Danny-Fuego/MicromouseDB/hardware/pcb/Micromouse.kicad_pcb

## KiCad design hardware/pcb/Micromouse.kicad_pcb (2026-08-09)

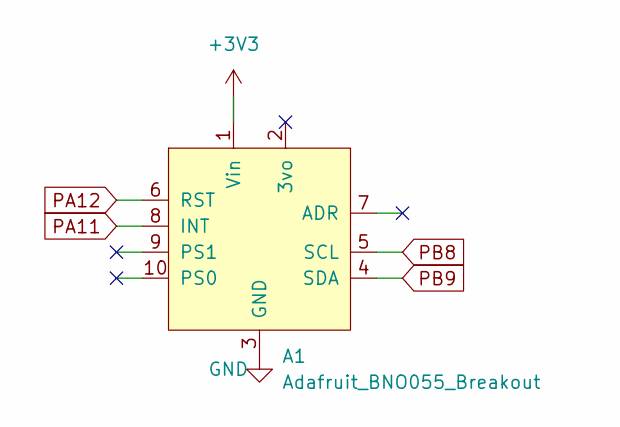
[picture p1: schematic Gyro.kicad_sch]

Parts:
A1: Adafruit_BNO055_Breakout; MODULE_2472

Connections:
+3V3: A1.1 (Vin); also elsewhere on the board
GND: A1.3 (GND); also elsewhere on the board
PA11: A1.8 (INT); also elsewhere on the board
PA12: A1.6 (RST); also elsewhere on the board
PB8: A1.5 (SCL); also elsewhere on the board
PB9: A1.4 (SDA); also elsewhere on the board

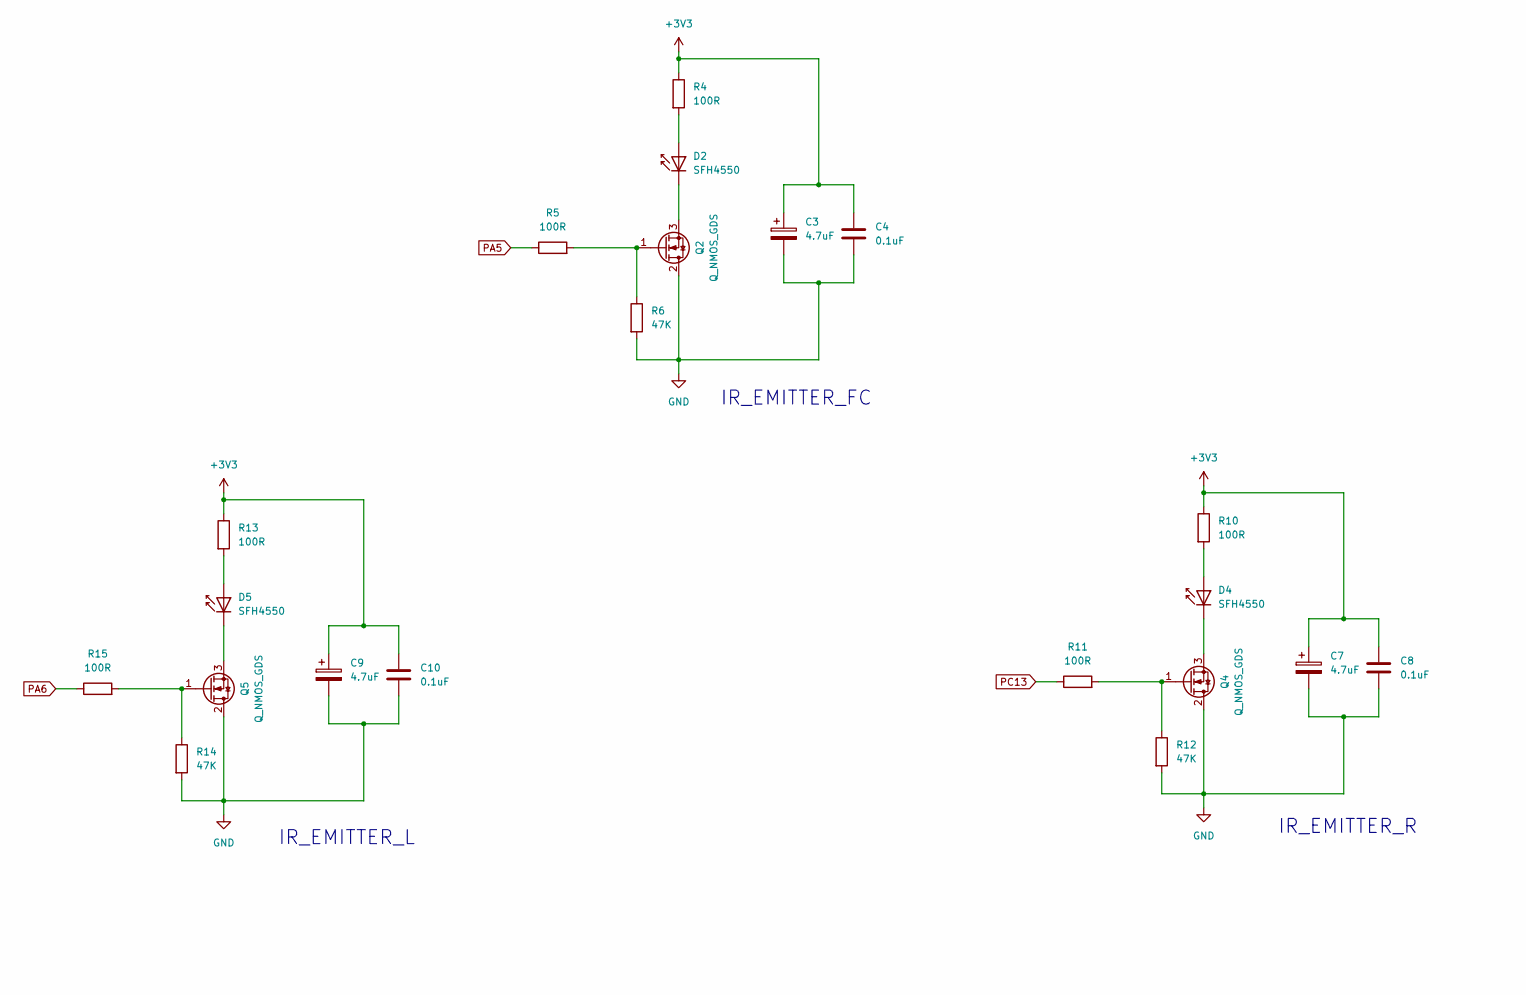
[picture p2: schematic IR_Sensors.kicad_sch, part in row 1, column 1]

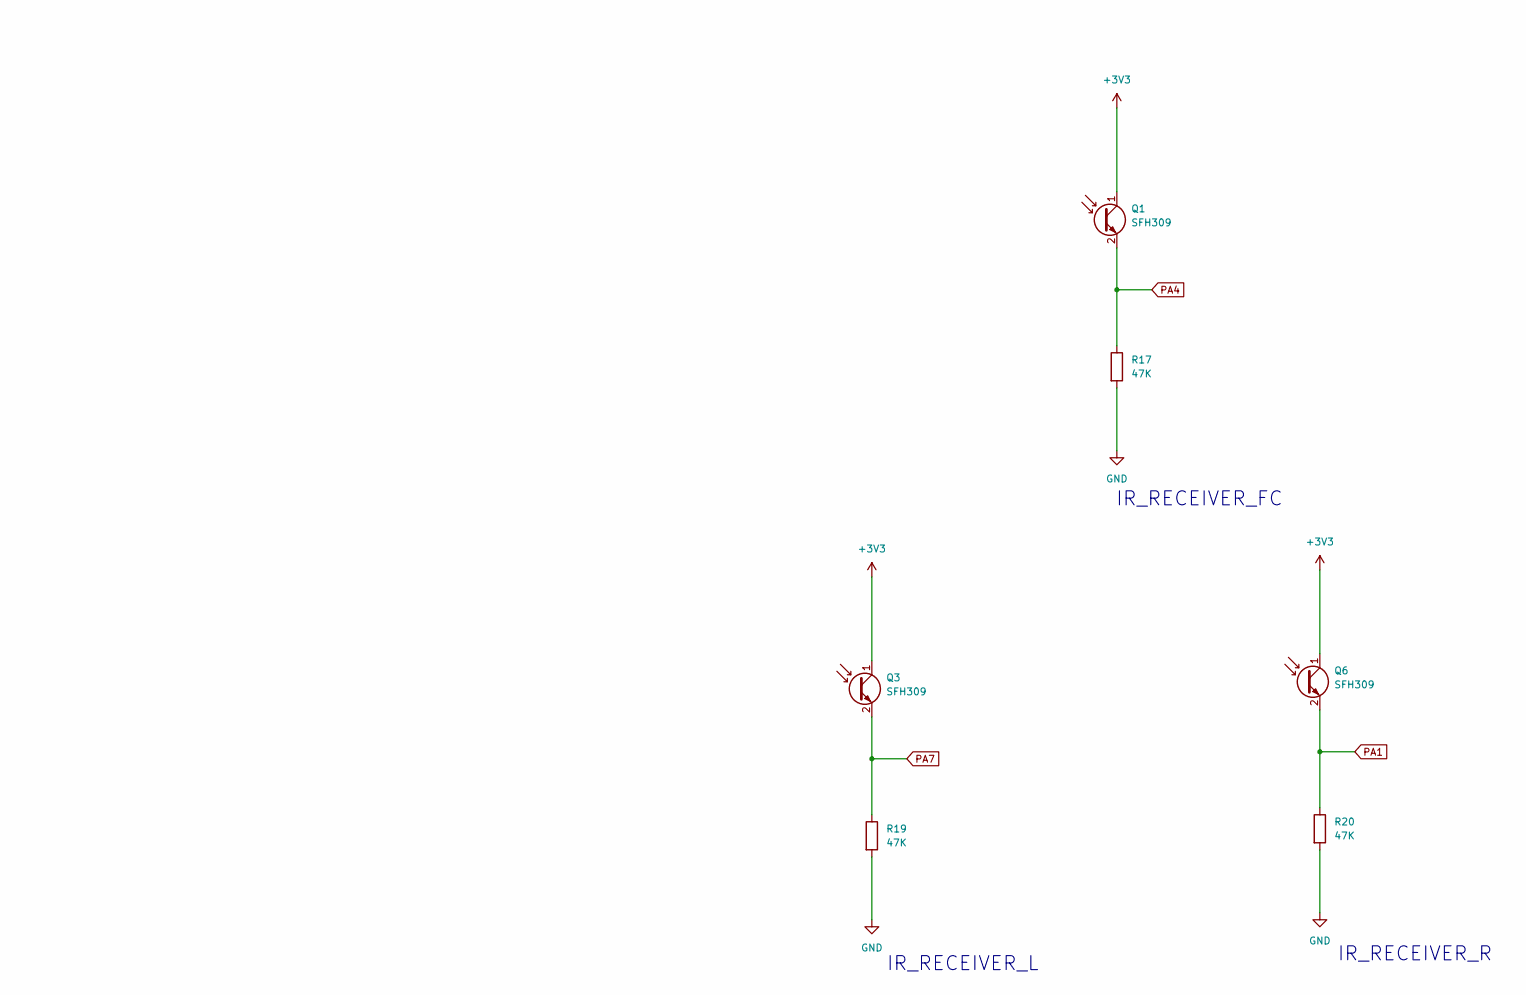
[picture p3: schematic IR_Sensors.kicad_sch, part in row 1, column 2]

Parts:
C3, C7, C9: 4.7uF; CP_Radial_D4.0mm_P1.50mm
C4, C8, C10: 0.1uF; C_0603_1608Metric
D2, D4, D5: SFH4550; LED_D3.0mm_IRGrey
Q1, Q3, Q6: SFH309; LED_D3.0mm_IRBlack
Q2, Q4, Q5: Q_NMOS_GDS; SOT-23
R4, R5, R10, R11, R13, R15: 100R; R_0603_1608Metric
R6, R12, R14, R17, R19, R20: 47K; R_0603_1608Metric

Connections:
+3V3: C3.1, C4.1, C7.1, C8.1, C9.1, C10.1, Q1.1 (C), Q3.1 (C), Q6.1 (C), R4.1, R10.1, R13.1; also elsewhere on the board
GND: C3.2, C4.2, C7.2, C8.2, C9.2, C10.2, Q2.2 (D), Q4.2 (D), Q5.2 (D), R6.2, R12.2, R14.2, R17.2, R19.2, R20.2; also elsewhere on the board
unnamed: D2.2 (A), R4.2
unnamed: D2.1 (K), Q2.3 (S)
unnamed: D4.2 (A), R10.2
unnamed: D4.1 (K), Q4.3 (S)
unnamed: D5.2 (A), R13.2
unnamed: D5.1 (K), Q5.3 (S)
unnamed: Q2.1 (G), R5.2, R6.1
unnamed: Q4.1 (G), R11.2, R12.1
unnamed: Q5.1 (G), R14.1, R15.2
PA1: Q6.2 (E), R20.1; also elsewhere on the board
PA4: Q1.2 (E), R17.1; also elsewhere on the board
PA5: R5.1; also elsewhere on the board
PA6: R15.1; also elsewhere on the board
PA7: Q3.2 (E), R19.1; also elsewhere on the board
PC13: R11.1; also elsewhere on the board

Notes on the sheet:
IR_RECEIVER_FC
IR_RECEIVER_L
IR_EMITTER_FC
IR_RECEIVER_R
IR_EMITTER_R
IR_EMITTER_L

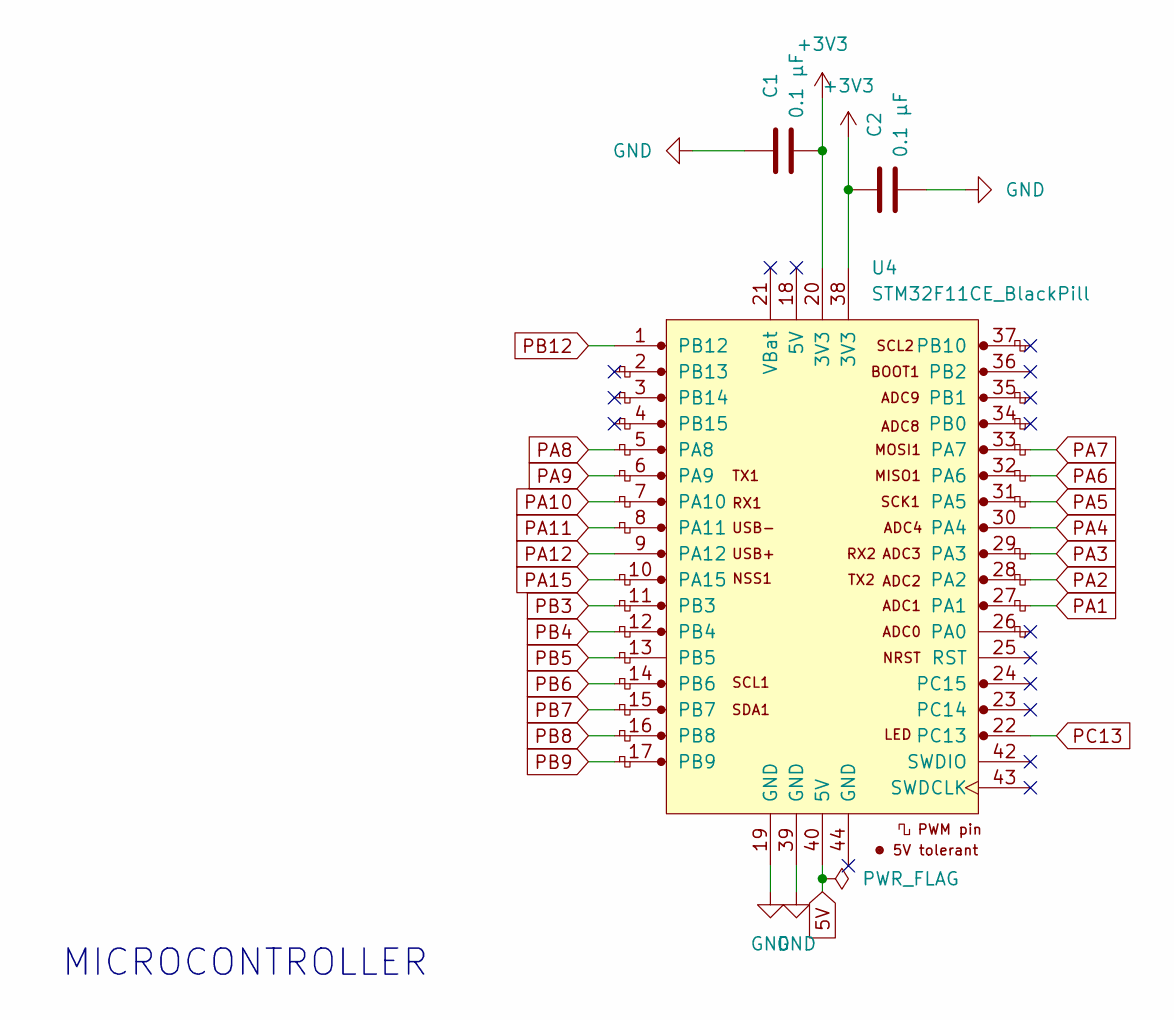
[picture p4: schematic Microcontroller.kicad_sch]

Parts:
C1, C2: 0.1 µF; C_0603_1608Metric
U4: STM32F11CE_BlackPill; YAAJ_BluePill_SWD_1

Connections:
5V: U4.40 (5V); also elsewhere on the board
+3V3: C1.2, C2.1, U4.20 (3V3), U4.38 (3V3); also elsewhere on the board
GND: C1.1, C2.2, U4.19 (GND), U4.39 (GND); also elsewhere on the board
PA1: U4.27 (PA1); also elsewhere on the board
PA2: U4.28 (PA2); also elsewhere on the board
PA3: U4.29 (PA3); also elsewhere on the board
PA4: U4.30 (PA4); also elsewhere on the board
PA5: U4.31 (PA5); also elsewhere on the board
PA6: U4.32 (PA6); also elsewhere on the board
PA7: U4.33 (PA7); also elsewhere on the board
PA8: U4.5 (PA8); also elsewhere on the board
PA9: U4.6 (PA9); also elsewhere on the board
PA10: U4.7 (PA10); also elsewhere on the board
PA11: U4.8 (PA11); also elsewhere on the board
PA12: U4.9 (PA12); also elsewhere on the board
PA15: U4.10 (PA15); also elsewhere on the board
PB3: U4.11 (PB3); also elsewhere on the board
PB4: U4.12 (PB4); also elsewhere on the board
PB5: U4.13 (PB5); also elsewhere on the board
PB6: U4.14 (PB6); also elsewhere on the board
PB7: U4.15 (PB7); also elsewhere on the board
PB8: U4.16 (PB8); also elsewhere on the board
PB9: U4.17 (PB9); also elsewhere on the board
PB12: U4.1 (PB12); also elsewhere on the board
PC13: U4.22 (PC13); also elsewhere on the board

Notes on the sheet:
MICROCONTROLLER

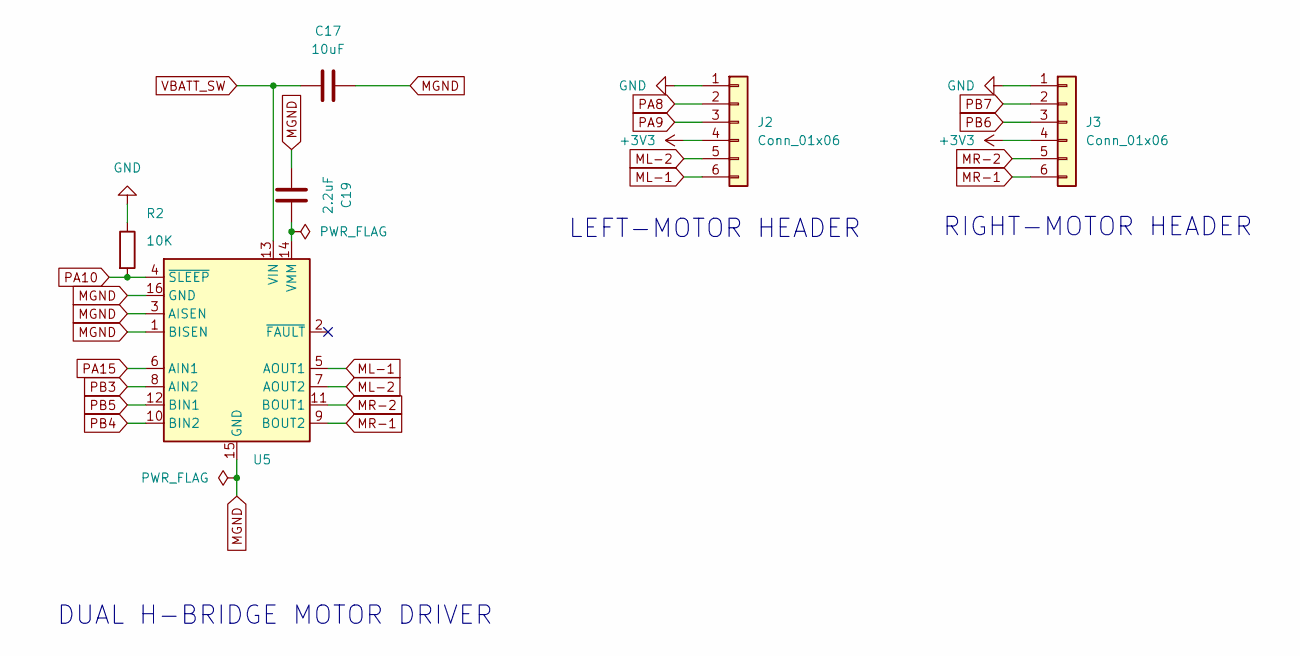
[picture p5: schematic Motor_Encoder.kicad_sch]

Parts:
C17: 10uF; C_0603_1608Metric
C19: 2.2uF; C_0603_1608Metric
J2, J3: Conn_01x06; PinHeader_1x06_P2.54mm_Vertical
R2: 10K; R_0603_1608Metric
U5: DRV8833_BreakoutBoard

Connections:
+3V3: J2.4, J3.4; also elsewhere on the board
GND: J2.1, J3.1, R2.1; also elsewhere on the board
MGND: C17.2, C19.1, U5.1 (BISEN), U5.3 (AISEN), U5.15 (GND), U5.16 (GND); also elsewhere on the board
ML-1: J2.6, U5.5 (AOUT1)
ML-2: J2.5, U5.7 (AOUT2)
MR-1: J3.6, U5.9 (BOUT2)
MR-2: J3.5, U5.11 (BOUT1)
unnamed: C19.2, U5.14 (VMM)
PA8: J2.2; also elsewhere on the board
PA9: J2.3; also elsewhere on the board
PA10: R2.2, U5.4 (~SLEEP); also elsewhere on the board
PA15: U5.6 (AIN1); also elsewhere on the board
PB3: U5.8 (AIN2); also elsewhere on the board
PB4: U5.10 (BIN2); also elsewhere on the board
PB5: U5.12 (BIN1); also elsewhere on the board
PB6: J3.3; also elsewhere on the board
PB7: J3.2; also elsewhere on the board
VBATT_SW: C17.1, U5.13 (VIN); also elsewhere on the board

Notes on the sheet:
DUAL H-BRIDGE MOTOR DRIVER
LEFT-MOTOR HEADER
RIGHT-MOTOR HEADER

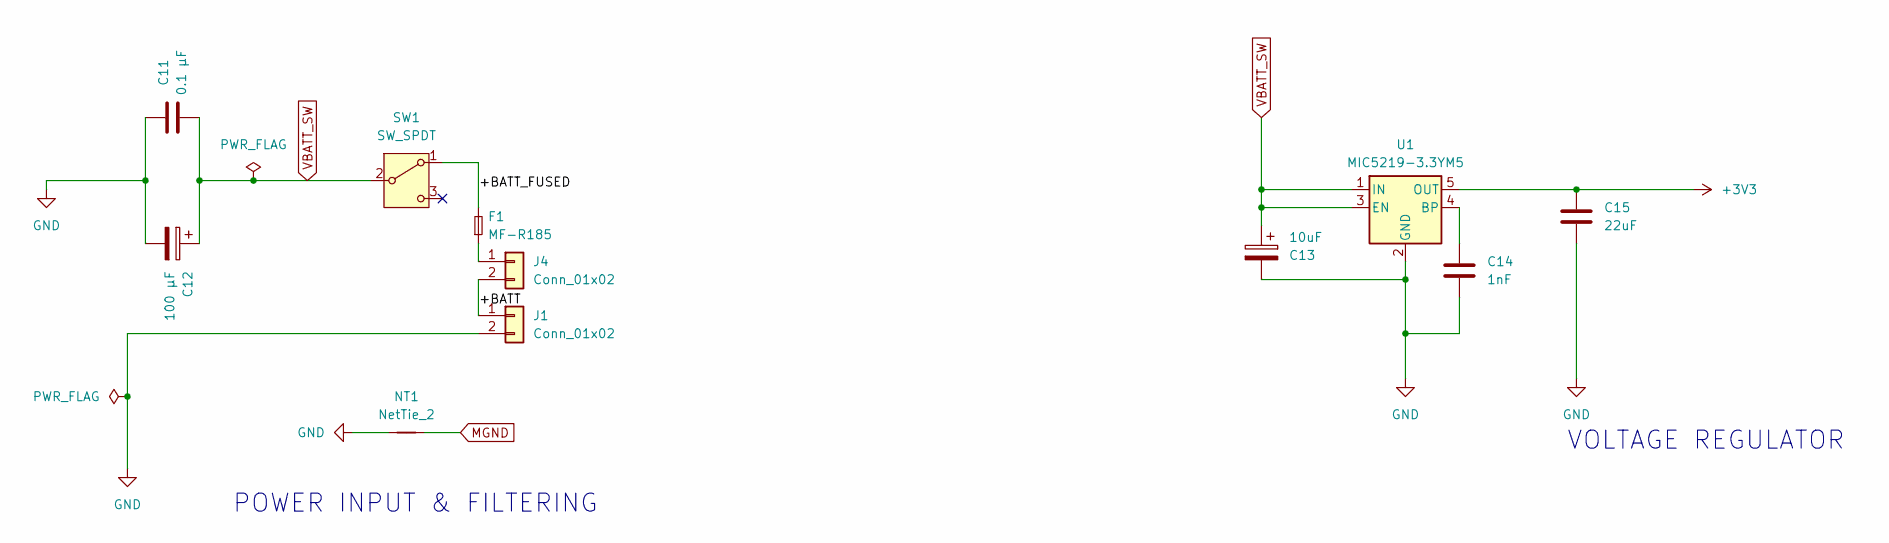
[picture p6: schematic Power.kicad_sch]

Parts:
C11: 0.1 µF; C_0603_1608Metric
C12: 100 µF; CP_Radial_D5.0mm_P2.00mm
C13: 10uF; CP_Radial_D5.0mm_P2.50mm
C14: 1nF; C_0603_1608Metric
C15: 22uF; C_0603_1608Metric
F1: MF-R185; Fuse_Bourns_MF-R185
J1, J4: Conn_01x02; JST_PH_B2B-PH-K_1x02_P2.00mm_Vertical
NT1: NetTie_2; NetTie-2_SMD_Pad2.0mm
SW1: SW_SPDT; SW_Slide-03_Wuerth-WS-SLTV_10x2.5x6.4_P2.54mm
U1: MIC5219-3.3YM5; SOT-23-5

Connections:
+3V3: C15.1, U1.5 (OUT); also elsewhere on the board
/Power/+BATT: J1.1, J4.2
/Power/+BATT_FUSED: F1.2, SW1.1 (A)
GND: C11.1, C12.2, C13.2, C14.2, C15.2, J1.2, NT1.1, U1.2 (GND); also elsewhere on the board
MGND: NT1.2; also elsewhere on the board
unnamed: F1.1, J4.1
unnamed: C14.1, U1.4 (BP)
VBATT_SW: C11.2, C12.1, C13.1, SW1.2 (B), U1.1 (IN), U1.3 (EN); also elsewhere on the board

Notes on the sheet:
POWER INPUT & FILTERING
VOLTAGE REGULATOR

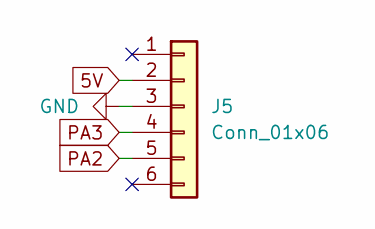
[picture p7: schematic bluetooth.kicad_sch]

Parts:
J5: Conn_01x06; PinHeader_1x06_P2.54mm_Vertical

Connections:
5V: J5.2; also elsewhere on the board
GND: J5.3; also elsewhere on the board
PA2: J5.5; also elsewhere on the board
PA3: J5.4; also elsewhere on the board

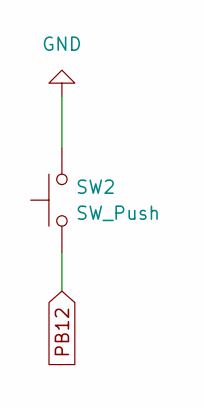
[picture p8: schematic button.kicad_sch]

Parts:
SW2: SW_Push; SW_PUSH_6mm

Connections:
GND: SW2.2; also elsewhere on the board
PB12: SW2.1; also elsewhere on the board

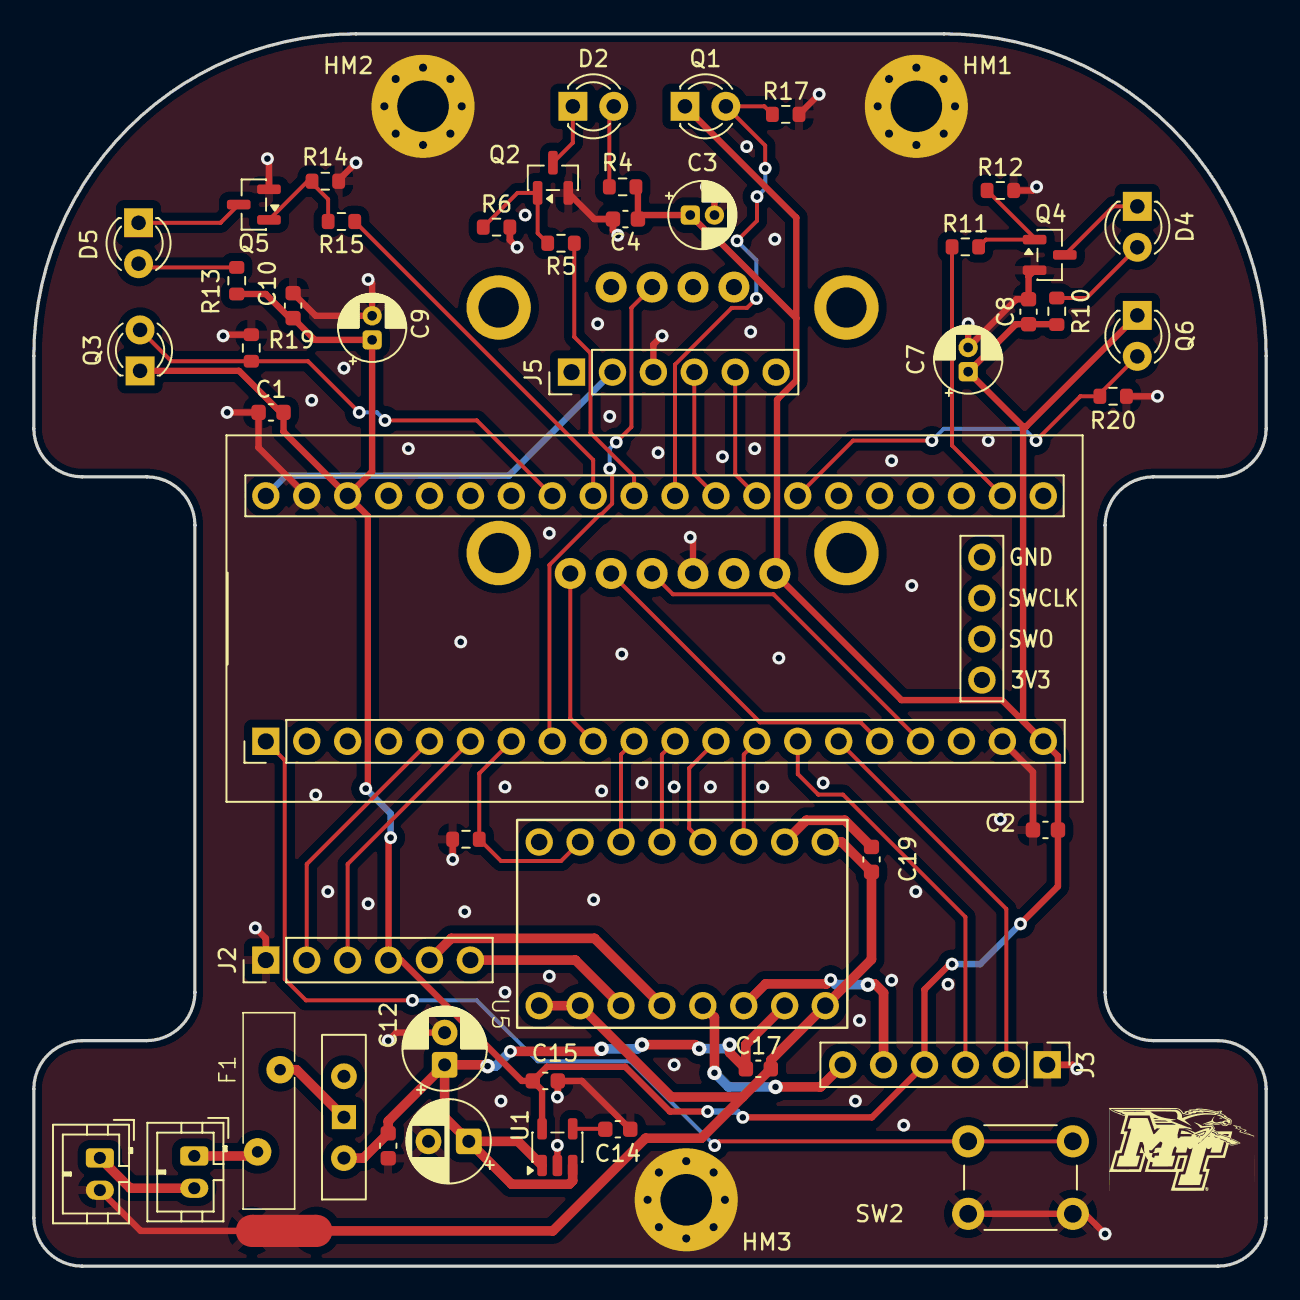
[picture p9: board Micromouse.kicad_pcb from above]

Board: 2 copper layers, 76.5 x 76.5 mm, 53 parts (1 on the bottom side), 45 nets.

Other parts of the board:
HM1, HM2, HM3: MountingHole_3.2mm_M3_Pad_Via

Their connections:
GND: HM1.1, HM2.1, HM3.1; also elsewhere on the board
