Danny-Fuego/MicromouseDB/firmware/Src/speed_controller.c

#include <speed_controller.h>

#define CONTROL_DT_SEC 0.010f
#define MM_PER_TICK 0.595f
#define PWM_MAX 1000

#define SPEED_KP 0.5f
#define SPEED_KI 0.1f
#define SPEED_KD 0.0f
#define ENABLE_DECEL_BIAS 0

#define MIN_USABLE_SPEED_MM_S 430.0f

static int32_t prevLeftCount  = 0;
static int32_t prevRightCount = 0;

static float leftIntegral  = 0.0f;
static float rightIntegral = 0.0f;

static float leftPrevError  = 0.0f;
static float rightPrevError = 0.0f;

static float leftMeasuredSpeed  = 0.0f;
static float rightMeasuredSpeed = 0.0f;

static int16_t leftPWM  = 0;
static int16_t rightPWM = 0;

static uint8_t hasStarted = 0;

#define LOOKUP_SIZE_L 10
#define LOOKUP_SIZE_R 12

// Left motor (new replacement) — calibrated 2026-07-08
// Deadzone below 500 PWM — motor spins but can't break friction
static const float leftSpeedBP[LOOKUP_SIZE_L] = {
    0.0f, 430.0f, 530.0f, 610.0f, 675.0f,
    735.0f, 795.0f, 880.0f, 968.0f, 1057.0f
};
static const float leftPWMTable[LOOKUP_SIZE_L] = {
    0.0f, 450.0f, 500.0f, 550.0f, 600.0f,
    650.0f, 700.0f, 750.0f, 800.0f, 850.0f
};

// Right motor — calibrated 2026-07-08
static const float rightSpeedBP[LOOKUP_SIZE_R] = {
    0.0f, 264.0f, 379.0f, 472.0f, 544.0f,
    609.0f, 667.0f, 731.0f, 832.0f, 948.0f,
    1052.0f, 1135.0f
};
static const float rightPWMTable[LOOKUP_SIZE_R] = {
    0.0f, 400.0f, 450.0f, 500.0f, 550.0f,
    600.0f, 650.0f, 700.0f, 750.0f, 800.0f,
    850.0f, 900.0f
};

static int16_t Controller_ClampPWM(float pwm)
{
    if (pwm >  PWM_MAX) return  PWM_MAX;
    if (pwm < -PWM_MAX) return -PWM_MAX;
    return (int16_t)pwm;
}

static float Controller_Lookup1D(float x,
                                  const float *xBP,
                                  const float *yTable,
                                  int size)
{
    if (x <= xBP[0]) return yTable[0];
    if (x >= xBP[size - 1]) return yTable[size - 1];
    for (int i = 0; i < size - 1; i++)
    {
        if (x >= xBP[i] && x <= xBP[i + 1])
        {
            float ratio = (x - xBP[i]) / (xBP[i + 1] - xBP[i]);
            return yTable[i] + ratio * (yTable[i + 1] - yTable[i]);
        }
    }
    return yTable[size - 1];
}

static float Controller_LookupLeftPWM(float speed)
{
    float absSpeed = fabsf(speed);
    float pwm = Controller_Lookup1D(absSpeed, leftSpeedBP, leftPWMTable, LOOKUP_SIZE_L);
    if (speed < 0.0f) pwm = -pwm;
    return pwm;
}

static float Controller_LookupRightPWM(float speed)
{
    float absSpeed = fabsf(speed);
    float pwm = Controller_Lookup1D(absSpeed, rightSpeedBP, rightPWMTable, LOOKUP_SIZE_R);
    if (speed < 0.0f) pwm = -pwm;
    return pwm;
}

static float Controller_PID(float target,
                             float measured,
                             float dt_sec,
                             float *integral,
                             float *prevError)
{
    float error = target - measured;
    if (fabsf(target) < 1.0f)
    {
        *integral  = 0.0f;
        *prevError = 0.0f;
        return 0.0f;
    }
    *integral += error * dt_sec;
    float derivative = (error - *prevError) / dt_sec;
    *prevError = error;
    return (SPEED_KP * error) + (SPEED_KI * (*integral)) + (SPEED_KD * derivative);
}

void Controller_Init(void) { Controller_Reset(); }

void Controller_Reset(void)
{
    Encoder_Update();
    prevLeftCount  = Encoder_GetLeftCount();
    prevRightCount = Encoder_GetRightCount();
    leftIntegral   = 0.0f;
    rightIntegral  = 0.0f;
    leftPrevError  = 0.0f;
    rightPrevError = 0.0f;
    leftMeasuredSpeed  = 0.0f;
    rightMeasuredSpeed = 0.0f;
    leftPWM    = 0;
    rightPWM   = 0;
    hasStarted = 0;
    Motor_SetRawPWM(0, 0);
}

void Controller_UpdateSpeed(float targetLeft_mm_s,
                             float targetRight_mm_s,
                             float dt_sec,
                             uint8_t isDecelerating,
                             float targetSpeed_mm_s,
                             float maxCruiseSpeed_mm_s,
                             float totalDist_mm)
{
    // Startup gate
    if (!hasStarted)
    {
        if (fabsf(targetLeft_mm_s)  < MIN_USABLE_SPEED_MM_S &&
            fabsf(targetRight_mm_s) < MIN_USABLE_SPEED_MM_S)
        {
            leftPWM  = 0;
            rightPWM = 0;
            Motor_SetRawPWM(0, 0);
            return;
        }
        else
        {
            hasStarted = 1;
        }
    }

    Encoder_Update();

    int32_t currentLeftCount  = Encoder_GetLeftCount();
    int32_t currentRightCount = Encoder_GetRightCount();
    int32_t dLeft  = currentLeftCount  - prevLeftCount;
    int32_t dRight = currentRightCount - prevRightCount;
    prevLeftCount  = currentLeftCount;
    prevRightCount = currentRightCount;

    leftMeasuredSpeed  = ((float)dLeft  / dt_sec) * MM_PER_TICK;
    rightMeasuredSpeed = ((float)dRight / dt_sec) * MM_PER_TICK;

    float leftFeedforward  = Controller_LookupLeftPWM(targetLeft_mm_s);
    float rightFeedforward = Controller_LookupRightPWM(targetRight_mm_s);

    // Average feedforward below 700mm/s during startup ramp
    if (fabsf(targetLeft_mm_s)  < 700.0f &&
        fabsf(targetRight_mm_s) < 700.0f)
    {
        float avgFF = 0.5f * (leftFeedforward + rightFeedforward);
        leftFeedforward  = avgFF;
        rightFeedforward = avgFF;
    }

    float leftCorrection =
        Controller_PID(targetLeft_mm_s,  leftMeasuredSpeed,
                       dt_sec, &leftIntegral,  &leftPrevError);
    float rightCorrection =
        Controller_PID(targetRight_mm_s, rightMeasuredSpeed,
                       dt_sec, &rightIntegral, &rightPrevError);

    // ── Proportional decel bias ───────────────────────────────────────────
    // Right motor is sluggish during deceleration — runs faster than left
    // for the same PWM. The gap grows as speed drops so we scale the bias
    // stronger at lower speeds. Works for all speeds and distances.
    float decelBias = 0.0f;
	#if ENABLE_DECEL_BIAS
		if (isDecelerating)
		{
			float speedDiff = rightMeasuredSpeed - leftMeasuredSpeed;
			if (speedDiff > 0.0f)
			{
				float sf = 1.0f - (targetSpeed_mm_s / maxCruiseSpeed_mm_s);
				if (sf < 0.0f) sf = 0.0f;
				if (sf > 1.0f) sf = 1.0f;
				float speedFactor = sqrtf(sf);

				// Logarithmic distance scaling — fitted to experimental data:
				// 254mm→15, 914mm→22, 3000mm→29
				float distCoeff = 5.670f * logf(totalDist_mm) - 16.40f;
				if (distCoeff <  3.0f) distCoeff =  3.0f;
				if (distCoeff > 35.0f) distCoeff = 35.0f;

				// Speed scaling — reduce coefficient as speed increases above 800mm/s
				// Every 100mm/s above 800 reduces coefficient by 1
				float speedPenalty = (maxCruiseSpeed_mm_s - 800.0f) / 100.0f;
				if (speedPenalty < 0.0f) speedPenalty = 0.0f;
				distCoeff -= speedPenalty;
				if (distCoeff < 3.0f) distCoeff = 3.0f;

				decelBias = speedDiff * (0.3f + speedFactor * distCoeff);
				if (decelBias > 500.0f) decelBias = 500.0f;
			}
		}
	#endif
    // ─────────────────────────────────────────────────────────────────────

    leftPWM  = Controller_ClampPWM(leftFeedforward  + leftCorrection);
    rightPWM = Controller_ClampPWM(rightFeedforward + rightCorrection - decelBias);

    Motor_SetRawPWM(leftPWM, rightPWM);
}

float Controller_GetLeftMeasuredSpeed(void)  { return leftMeasuredSpeed; }
float Controller_GetRightMeasuredSpeed(void) { return rightMeasuredSpeed; }
int16_t Controller_GetLeftPWM(void)          { return leftPWM; }
int16_t Controller_GetRightPWM(void)         { return rightPWM; }
