Danny-Fuego/MicromouseDB/firmware/Inc/calibration.h

#ifndef CALIBRATION_H
#define CALIBRATION_H

#include "main.h"
#include "encoder.h"
#include "motor.h"
#include "bno055.h"
#include "button.h"
#include "speed_controller.h"
#include "motion_profile.h"
#include "straight_controller.h"
#include "motion_guard.h"
#include <math.h>
#include <stdlib.h>
#include <stdio.h>
#include <string.h>
#include <stdarg.h>

void Calibration_Run(void);

#endif
