Danny-Fuego/MicromouseDB/(commit log)

2026-08-09 Add KiCad pcb hardware design
    [Gyro.kicad_sch, IR_Sensors.kicad_sch, LEDs.kicad_sch, Microcontroller.kicad_sch, Micromouse.kicad_pcb, Motor_Encoder.kicad_sch, Power.kicad_sch, bluetooth.kicad_sch]
2026-08-11 Uploaded the current code on the micromouse
